System-J-Synthesizers/ClockDivider/pcb/clock_divider.kicad_pcb

## KiCad design pcb/clock_divider.kicad_pcb (2023-11-15)

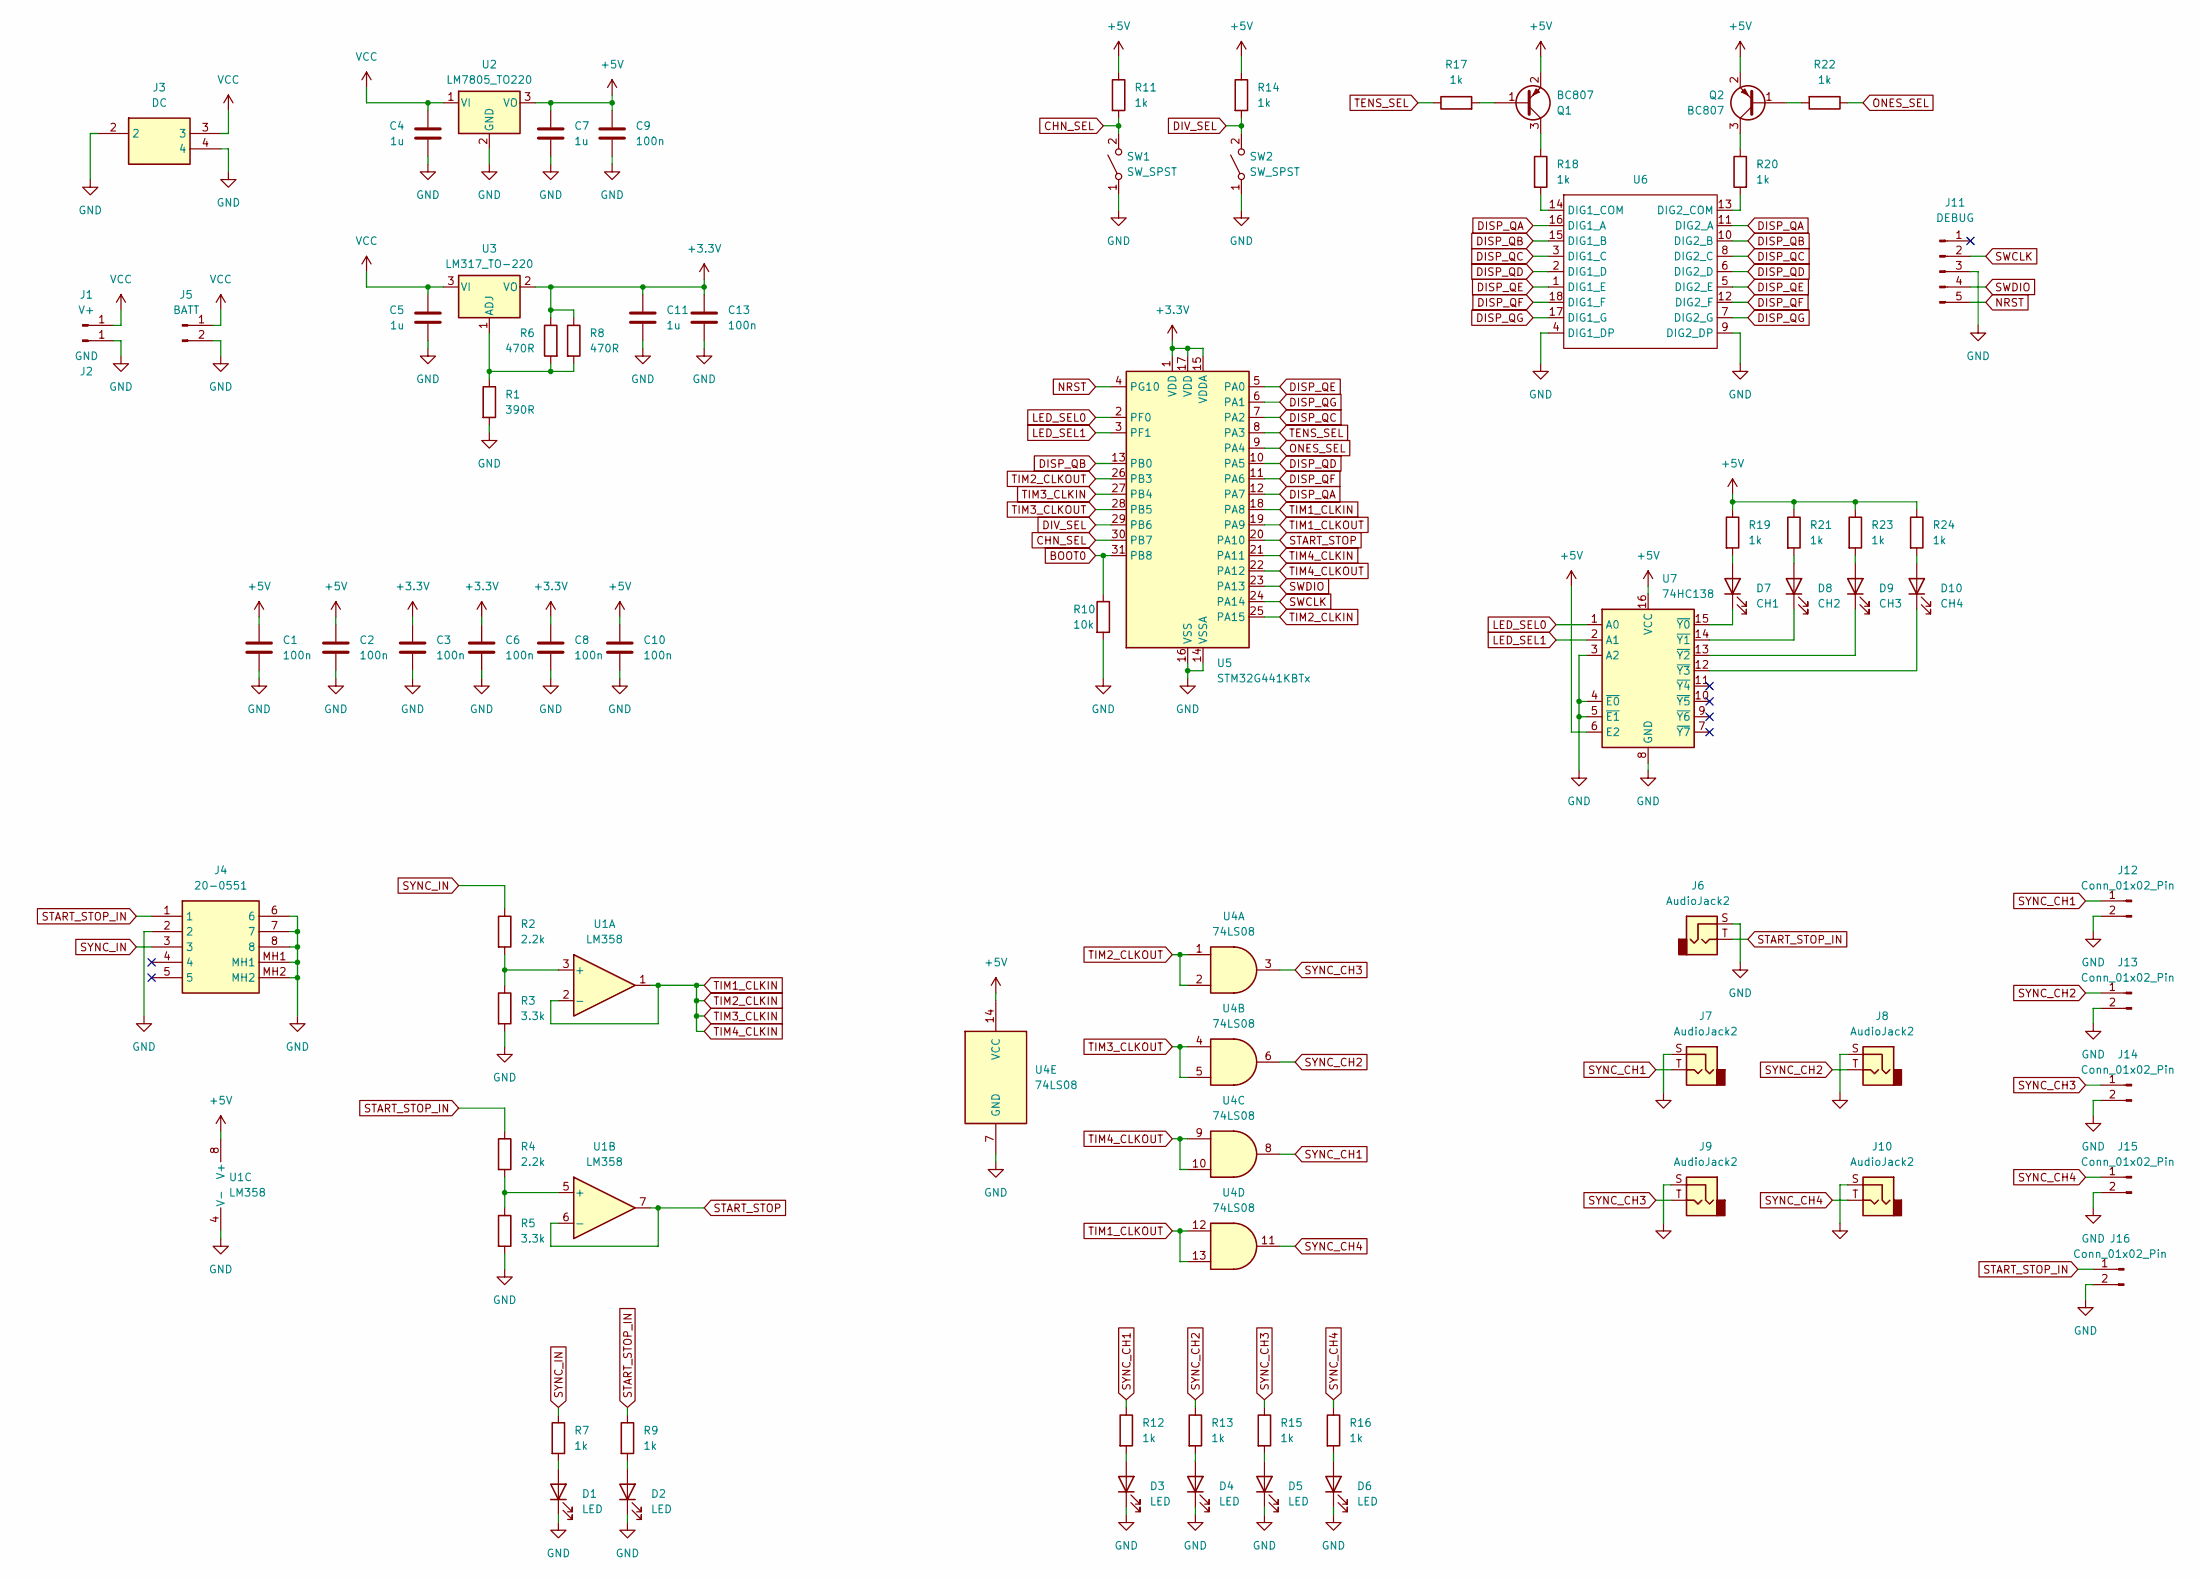
[picture p1: schematic clock_divider.kicad_sch]

Parts:
C1, C2, C3, C6, C8, C9, C10, C13: 100n; C_0603_1608Metric
C4, C5, C7, C11: 1u; C_0603_1608Metric
D1, D2, D3, D4, D5, D6: LED; LED_0603_1608Metric
D7: CH1; LED_0603_1608Metric
D8: CH2; LED_0603_1608Metric
D9: CH3; LED_0603_1608Metric
D10: CH4; LED_0603_1608Metric
J1: V+; PinHeader_1x01_P2.54mm_Vertical
J2: GND; PinHeader_1x01_P2.54mm_Vertical
J3: DC; 200975; Manufacturer_Part_Number 20-0975
J4: 20-0551; 200551; Manufacturer_Part_Number 20-0551
J5: BATT; PinHeader_1x02_P2.54mm_Vertical
J6, J7, J8, J9, J10: AudioJack2; Jack_3.5mm_QingPu_WQP-PJ398SM_Vertical
J11: DEBUG; PinHeader_1x05_P2.54mm_Vertical
J12, J13, J14, J15, J16: Conn_01x02_Pin; PinHeader_1x02_P2.54mm_Vertical
Q1, Q2: BC807; SOT-23
R1: 390R; R_0603_1608Metric
R2, R4: 2.2k; R_0603_1608Metric
R3, R5: 3.3k; R_0603_1608Metric
R6, R8: 470R; R_0603_1608Metric
R7, R9, R11, R12, R13, R14, R15, R16, R17, R18, R19, R20, R21, R22, R23, R24: 1k; R_0603_1608Metric
R10: 10k; R_0603_1608Metric
SW1, SW2: SW_SPST; SW_PUSH_6mm
U1: LM358; SOIC-8_3.9x4.9mm_P1.27mm
U2: LM7805_TO220; TO-220-3_Vertical
U3: LM317_TO-220; TO-220-3_Vertical
U4: 74LS08; DIP-14_W7.62mm
U5: STM32G441KBTx; LQFP-32_7x7mm_P0.8mm
U6: OSL20561
U7: 74HC138; DIP-16_W7.62mm

Connections:
+3.3V: C3.1, C6.1, C8.1, C11.1, C13.1, R6.1, R8.1, U3.2 (VO), U5.1 (VDD), U5.15 (VDDA), U5.17 (VDD)
+5V: C1.1, C2.1, C7.1, C9.1, C10.1, Q1.2 (E), Q2.2 (E), R11.1, R14.1, R19.1, R21.1, R23.1, R24.1, U1.8 (V+), U2.3 (VO), U4.14 (VCC), U7.6 (E2), U7.16 (VCC)
BOOT0: R10.1, U5.31 (PB8)
CHN_SEL: R11.2, SW1.2 (B), U5.30 (PB7)
DISP_QA: U5.12 (PA7), U6.11 (DIG2_A), U6.16 (DIG1_A)
DISP_QB: U5.13 (PB0), U6.10 (DIG2_B), U6.15 (DIG1_B)
DISP_QC: U5.7 (PA2), U6.3 (DIG1_C), U6.8 (DIG2_C)
DISP_QD: U5.10 (PA5), U6.2 (DIG1_D), U6.6 (DIG2_D)
DISP_QE: U5.5 (PA0), U6.1 (DIG1_E), U6.5 (DIG2_E)
DISP_QF: U5.11 (PA6), U6.12 (DIG2_F), U6.18 (DIG1_F)
DISP_QG: U5.6 (PA1), U6.7 (DIG2_G), U6.17 (DIG1_G)
DIV_SEL: R14.2, SW2.2 (B), U5.29 (PB6)
GND: C1.2, C2.2, C3.2, C4.2, C5.2, C6.2, C7.2, C8.2, C9.2, C10.2, C11.2, C13.2, D1.1 (K), D2.1 (K), D3.1 (K), D4.1 (K), D5.1 (K), D6.1 (K), J2.1, J3.2, J3.4, J4.2, J4.6, J4.7, J4.8, J4.MH1, J4.MH2, J5.2, J6.S, J7.S, J8.S, J9.S, J10.S, J11.3, J12.2, J13.2, J14.2, J15.2, J16.2, R1.2, R3.2, R5.2, R10.2, SW1.1 (A), SW2.1 (A), U1.4 (V-), U2.2 (GND), U4.7 (GND), U5.14 (VSSA), U5.16 (VSS), U5.32 (VSS), U6.4 (DIG1_DP), U6.9 (DIG2_DP), U7.3 (A2), U7.4 (~E0), U7.5 (~E1), U7.8 (GND)
LED_SEL0: U5.2 (PF0), U7.1 (A0)
LED_SEL1: U5.3 (PF1), U7.2 (A1)
NRST: J11.5, U5.4 (PG10)
unnamed: D1.2 (A), R7.2
unnamed: D2.2 (A), R9.2
unnamed: D3.2 (A), R12.2
unnamed: D4.2 (A), R13.2
unnamed: D5.2 (A), R15.2
unnamed: D6.2 (A), R16.2
unnamed: D7.2 (A), R19.2
unnamed: D7.1 (K), U7.15 (~Y0)
unnamed: D8.2 (A), R21.2
unnamed: D8.1 (K), U7.14 (~Y1)
unnamed: D9.2 (A), R23.2
unnamed: D9.1 (K), U7.13 (~Y2)
unnamed: D10.2 (A), R24.2
unnamed: D10.1 (K), U7.12 (~Y3)
unnamed: Q1.1 (B), R17.2
unnamed: Q1.3 (C), R18.1
unnamed: Q2.1 (B), R22.2
unnamed: Q2.3 (C), R20.1
unnamed: R2.2, R3.1, U1.3 (+)
unnamed: R4.2, R5.1, U1.5 (+)
unnamed: R1.1, R6.2, R8.2, U3.1 (ADJ)
unnamed: R18.2, U6.14 (DIG1_COM)
unnamed: R20.2, U6.13 (DIG2_COM)
ONES_SEL: R22.1, U5.9 (PA4)
START_STOP: U1.6 (-), U1.7, U5.20 (PA10)
START_STOP_IN: J4.1, J6.T, J16.1, R4.1, R9.1
SWCLK: J11.2, U5.24 (PA14)
SWDIO: J11.4, U5.23 (PA13)
SYNC_CH1: J7.T, J12.1, R12.1, U4.8
SYNC_CH2: J8.T, J13.1, R13.1, U4.6
SYNC_CH3: J9.T, J14.1, R15.1, U4.3
SYNC_CH4: J10.T, J15.1, R16.1, U4.11
SYNC_IN: J4.3, R2.1, R7.1
TENS_SEL: R17.1, U5.8 (PA3)
TIM1_CLKIN: U1.1, U1.2 (-), U5.18 (PA8), U5.21 (PA11), U5.25 (PA15), U5.27 (PB4)
TIM1_CLKOUT: U4.12, U4.13, U5.19 (PA9)
TIM2_CLKOUT: U4.1, U4.2, U5.26 (PB3)
TIM3_CLKOUT: U4.4, U4.5, U5.28 (PB5)
TIM4_CLKOUT: U4.9, U4.10, U5.22 (PA12)
VCC: C4.1, C5.1, J1.1, J3.3, J5.1, U2.1 (VI), U3.3 (VI)

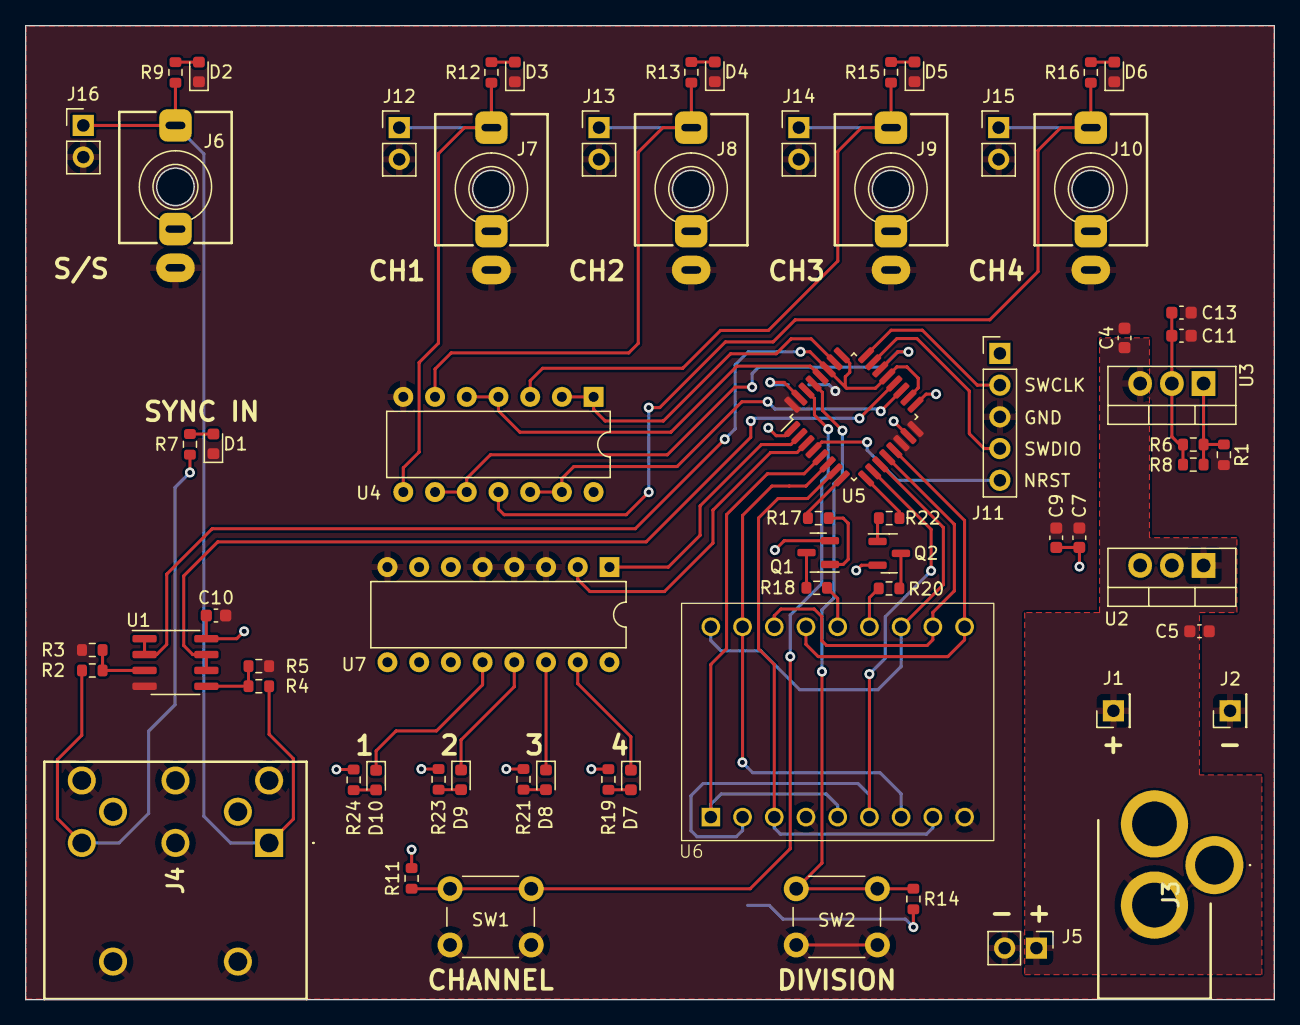
[picture p2: board clock_divider.kicad_pcb from above]

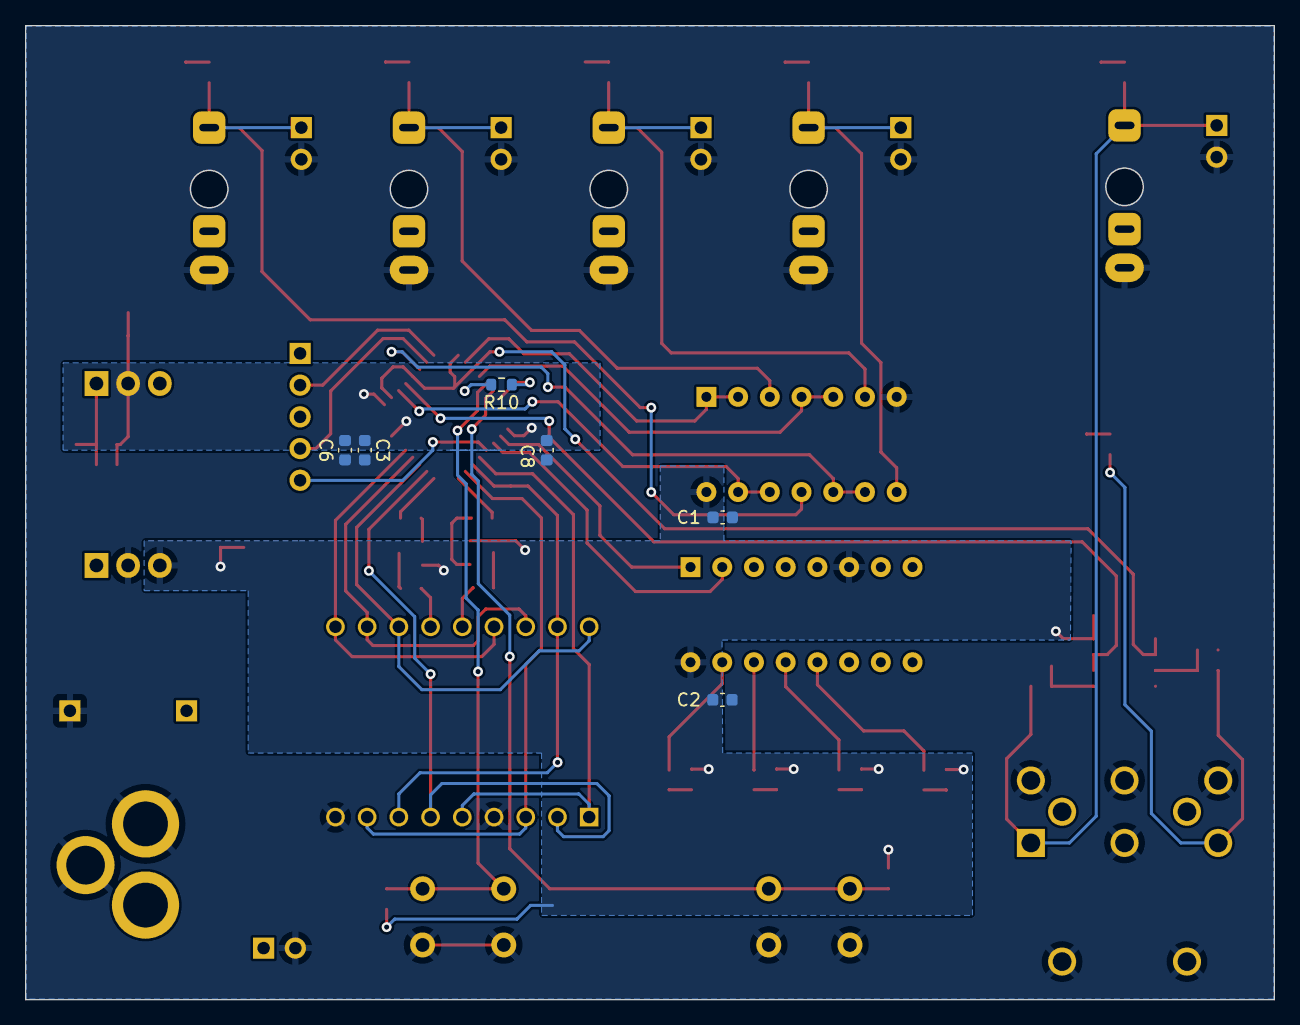
[picture p3: board clock_divider.kicad_pcb from below]

Board: 2 copper layers, 100.0 x 78.0 mm, 73 parts (6 on the bottom side), 56 nets.
