System-J-Synthesizers/ClockDivider/firmware/clock_divider.ioc

Mcu.UserName=STM32G441KBTx
PA0.GPIO_Label=DISP_QA
PA0.Signal=GPIO_Output
PA1.GPIO_Label=DISP_QB
PA1.Signal=GPIO_Output
PA10.GPIO_Label=START_STOP
PA10.Signal=GPIO_Input
PA11.GPIO_Label=TIM4_CLKIN
PA11.Signal=S_TIM4_CH1
PA12.GPIO_Label=TIM4_CLKOUT
PA12.Signal=S_TIM4_CH2
PA13.GPIO_Label=SWDIO
PA13.Signal=SYS_JTMS-SWDIO
PA14.GPIO_Label=SWCLK
PA14.Signal=SYS_JTCK-SWCLK
PA15.GPIO_Label=TIM2_CLKIN
PA15.Signal=S_TIM2_CH1
PA2.GPIO_Label=DISP_QC
PA2.Signal=GPIO_Output
PA3.GPIO_Label=TENS_SEL
PA3.Signal=GPIO_Output
PA4.GPIO_Label=ONES_SEL
PA4.Signal=GPIO_Output
PA5.GPIO_Label=DISP_QD
PA5.Signal=GPIO_Output
PA6.GPIO_Label=DISP_QE
PA6.Signal=GPIO_Output
PA7.GPIO_Label=DISP_QF
PA7.Signal=GPIO_Output
PA8.GPIO_Label=TIM1_CLKIN
PA8.Signal=S_TIM1_CH1
PA9.GPIO_Label=TIM1_CLKOUT
PA9.Signal=S_TIM1_CH2
PB0.GPIO_Label=DISP_QG
PB0.Signal=GPIO_Output
PB3.GPIO_Label=TIM2_CLKOUT
PB3.Signal=S_TIM2_CH2
PB4.GPIO_Label=TIM3_CLKIN
PB4.Signal=S_TIM3_CH1
PB5.GPIO_Label=TIM3_CLKOUT
PB5.Signal=S_TIM3_CH2
PB6.GPIO_Label=CHN_SEL
PB6.Signal=GPIO_Input
PB7.GPIO_Label=DIV_SEL
PB7.Signal=GPIO_Input
PB8-BOOT0.GPIO_Label=BOOT0
PB8-BOOT0.Signal=GPIO_Input
PF0-OSC_IN.GPIO_Label=LED_SEL0
PF0-OSC_IN.Signal=GPIO_Output
PF1-OSC_OUT.GPIO_Label=LED_SEL1
PF1-OSC_OUT.Signal=GPIO_Output
PG10-NRST.GPIO_Label=NRST
PG10-NRST.Signal=GPIO_Input
