System-J-Synthesizers/ClockDivider/firmware/hal/port/chip.c

#include <stdint.h>
#include "stm32g441xx.h"
#include "port_chip.h"
#include "../hal_chip.h"
#include "../hal_assert.h"

void chip_enable_isrs(void) {
	asm("cpsie i\n\t");
}

void chip_disable_isrs(void) {
	asm("cpsid i\n\t");
}
